WsprryPi/Wsprry_Pi_Hat_Designs/README.md

# Wsprry Pi µHAT
