WsprryPi/Wsprry_Pi_Hat_Designs/Wsprry Pi µHAT/KiCad Design/Wsprry_Pi_uHAT.kicad_pcb

## KiCad design Wsprry Pi µHAT/KiCad Design/Wsprry_Pi_uHAT.kicad_pcb (2026-02-14)

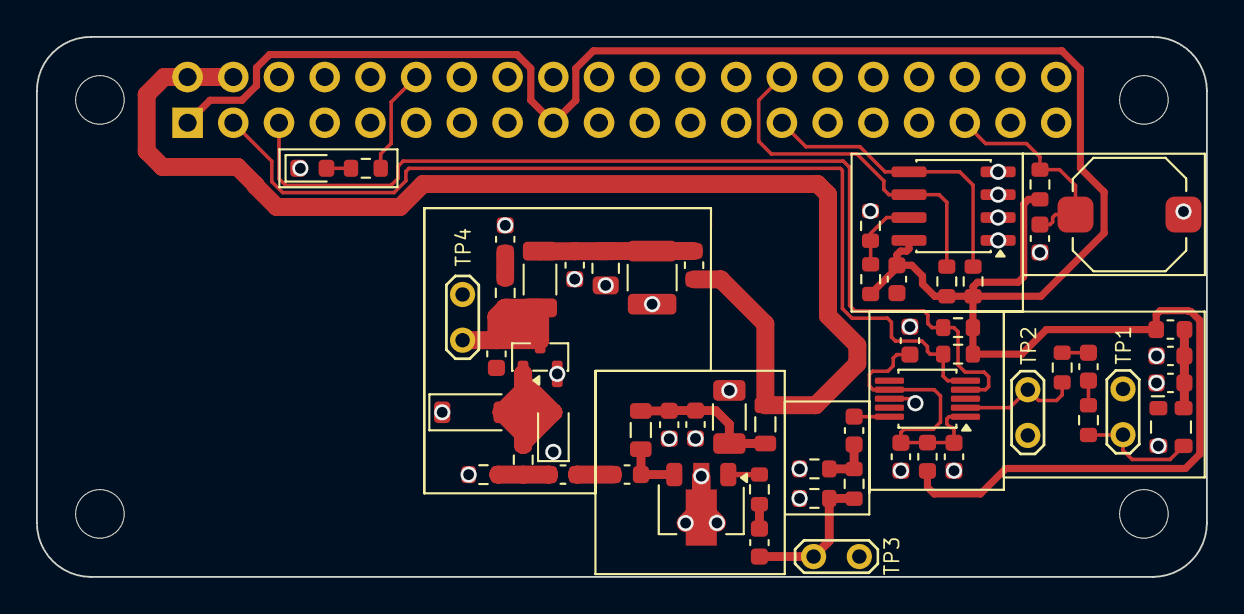
[picture p1: board Wsprry_Pi_uHAT.kicad_pcb from above]

Board: 2 copper layers, 65.0 x 30.0 mm, 61 parts (1 on the bottom side), 30 nets.

Parts:
C1, C5, C7, C10, C20: 0.1µF; C_0603_1608Metric
C2: 0.1uF; C_0603_1608Metric
C3: 1.0uF; C_0603_1608Metric
C4: 1nF; C_0603_1608Metric
C6, C9: 1.0µF; C_0603_1608Metric
C8: 1uF; C_0603_1608Metric
C11: 1µF; C_0603_1608Metric
C12: 10µF; C_1206_3216Metric
C13: 0.1F; C_0603_1608Metric
C14: 100n; C_0603_1608Metric
C15: 22nF; C_0603_1608Metric
C16: 22pF; C_0603_1608Metric
C17: 100pF; C_0603_1608Metric
C18: 10µF; C_1210_3225Metric
C19: 1.0µF; C_0805_2012Metric
D1: RED; LED_0603_1608Metric
D2: BAT54J; D_SOD-323F
D3: 5.1V; D_SOD-123
FB1, FB2: 600Ω@100MHz; L_0603_1608Metric
FB3: 600Ω100MHz; L_0805_2012Metric
FB4: 600Ω@100MHZ; L_0603_1608Metric
J1: Raspberry Pi Header; PinSocket_2x20_P2.54mm_Vertical
L1: 2.2µH; L_0805_2012Metric
L2: 2.2µH; L_1206_3216Metric
MH1, MH2, MH3, MH4: MountingHole_2.7mm_M2.5
Q1: AO3400A; SOT-23
R1: 270Ω; R_0603_1608Metric
R2: 10kΩ; R_0603_1608Metric
R3: 33Ω; R_0603_1608Metric
R4, R7, R13: 0Ω; R_0603_1608Metric
R5, R6: 2K2; R_0603_1608Metric
R8, R10: 292Ω; R_0603_1608Metric
R9: 17.6Ω; R_0603_1608Metric
R11: 47kΩ; R_0603_1608Metric
R12, R14: 3.9K; R_0603_1608Metric
R15: 49.9Ω; R_0603_1608Metric
R16: 10Ω; R_0603_1608Metric
R17: 100Ω; R_0603_1608Metric
SW1: SW_Push; SW_Push_1TS009xxxx-xxxx-xxxx_6x6x5mm
TP1: TP_XRAW; TestPoint_2Pads_Pitch2.54mm_Drill0.8mm
TP2: TP_XREF; TestPoint_2Pads_Pitch2.54mm_Drill0.8mm
TP3: TP_PAD_OUT; TestPoint_2Pads_Pitch2.54mm_Drill0.8mm
TP4: TP_PAOUT; TestPoint_2Pads_Pitch2.54mm_Drill0.8mm
U1: GVA-84; SOT-89-3
U2: 24LC128; SOIC-8_3.9x4.9mm_P1.27mm
Y1: ATX-11-F-27.000MHZ-F05-T; Oscillator_SMD_SeikoEpson_TG2520SMN-xxx-xxxxxx-4Pin_2.5x2.0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
Y2: Si5351A-B-GT; MSOP-10_3x3mm_P0.5mm

Connections:
3V3: C14.2, FB1.2, FB2.1, J1.1 (3V3), J1.17 (3V3), R2.1, R5.2, R6.2, R12.1, R13.2, R14.1, U2.8 (VCC)
5V: FB3.2, FB4.1, J1.2 (5V), J1.4 (5V)
/HAT+ EEPROM/ID_SCL: J1.28 (ID_SCL), R14.2, U2.6 (SCL)
/HAT+ EEPROM/ID_SDA: J1.27 (ID_SDA), R12.2, U2.5 (SDA)
/Raspberry Pi Header/PI_SCL: J1.5 (I2C1_SCL), R5.1, Y2.4 (SCL)
/Raspberry Pi Header/PI_SDA: J1.3 (I2C1_SDA), R6.1, Y2.5 (SDA)
/Raspberry Pi Header/PI_SHUTDOWN: C1.1, J1.35 (GPIO19), R2.2, SW1.1
/Raspberry Pi Header/PI_TXLED: J1.12 (GPIO18), R1.2
/Si5153 Chain/3dB Pi Pad/3DB_PAD_OUT: C8.1, R9.2, R10.1, TP3.1
/Si5153 Chain/3dB Pi Pad/CLOCK_IN: C13.1, Y2.10 (CLK0)
/Si5153 Chain/Clock/XTAL_IN: R4.2, TP2.1, Y2.2 (XA)
/Si5153 Chain/Final PA/MMIC_IN: C11.1, C15.1
/Si5153 Chain/Final PA/PA_OUT: C16.2, L2.2, Q1.3 (D), R17.1, TP4.1
GND: C1.2, C2.1, C3.1, C5.2, C6.2, C7.2, C9.2, C10.2, C12.2, C14.1, C16.1, C17.2, C18.2, C19.2, C20.2, D1.1 (K), D2.1 (K), D3.1 (K), J1.9 (GND), J1.25 (GND), J1.39 (GND), Q1.2 (S), R8.2, R10.2, R11.2, R15.2, SW1.2, TP1.2, TP2.2, TP3.2, TP4.2, U1.2 (GND), U2.1 (A0), U2.2 (A1), U2.3 (A2), U2.4 (GND), Y1.2 (GND), Y2.8 (GND)
unnamed: C4.1, R3.2
unnamed: C4.2, R4.1
unnamed: C8.2, R7.1
unnamed: C9.1, C10.1, C12.1, FB3.1, L1.1
unnamed: C11.2, L1.2, U1.3
unnamed: C13.2, R8.1, R9.1
unnamed: C15.2, R15.1, R16.1
unnamed: C17.1, R17.2
unnamed: C18.1, C19.1, C20.1, FB4.2, L2.1
unnamed: D1.2 (A), R1.1
unnamed: D2.2 (A), D3.2 (A), Q1.1 (G), R16.2
unnamed: R7.2, U1.1
unnamed: R11.1, R13.1, U2.7 (WP)
unnamed: R3.1, TP1.1, Y1.3 (OUT)
unnamed: C2.2, C3.2, FB1.1, Y1.4 (Vcc)
unnamed: C5.1, C6.1, C7.1, FB2.2, Y2.1 (VDD), Y2.7 (VDDO)
