WsprryPi/Wsprry_Pi_Hat_Designs/Raspberry Pi HAT EEPROM/KiCad Design/Raspberry Pi HAT EEPROM.kicad_sch

## KiCad design Raspberry Pi HAT EEPROM/KiCad Design/Raspberry Pi HAT EEPROM.kicad_sch (2026-02-14)

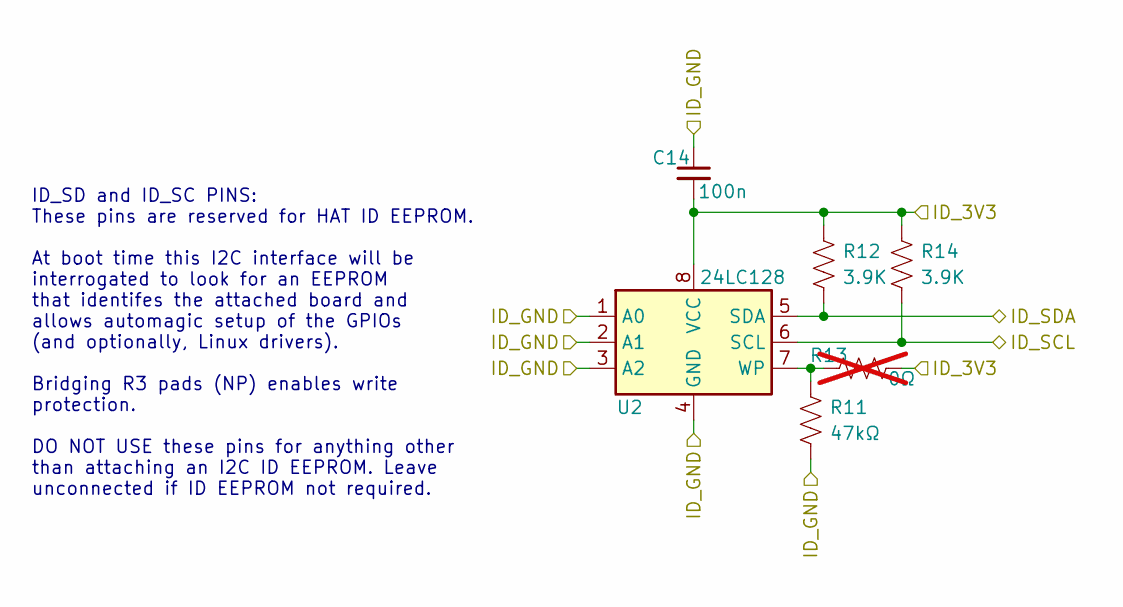
[picture p2: schematic Raspberry Pi HAT EEPROM.kicad_sch]

Parts:
C14: 100n; C_0603_1608Metric
R11: 47kΩ; R_0603_1608Metric
R12, R14: 3.9K; R_0603_1608Metric
R13: 0Ω; R_0603_1608Metric; not fitted
U2: 24LC128; SOIC-8_3.9x4.9mm_P1.27mm

Connections:
ID_3V3: C14.2, R12.1, R13.2, R14.1, U2.8 (VCC)
ID_GND: C14.1, R11.2, U2.1 (A0), U2.2 (A1), U2.3 (A2), U2.4 (GND)
ID_SCL: R14.2, U2.6 (SCL)
ID_SDA: R12.2, U2.5 (SDA)
unnamed: R11.1, R13.1, U2.7 (WP)

Notes on the sheet:
ID_SD and ID_SC PINS: These pins are reserved for HAT ID EEPROM. At boot time this I2C interface will be interrogated to look for an EEPROM that identifes the attached board and allows automagic setup of the GPIOs (and optionally, Linux drivers). Bridging R3 pads (NP) enables write protection. DO N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
