WsprryPi/Wsprry_Pi_Hat_Designs/Wsprry Pi Controls/KiCad Design/Wsprry Pi Controls.kicad_sch

## KiCad design Wsprry Pi Controls/KiCad Design/Wsprry Pi Controls.kicad_sch (2026-02-14)

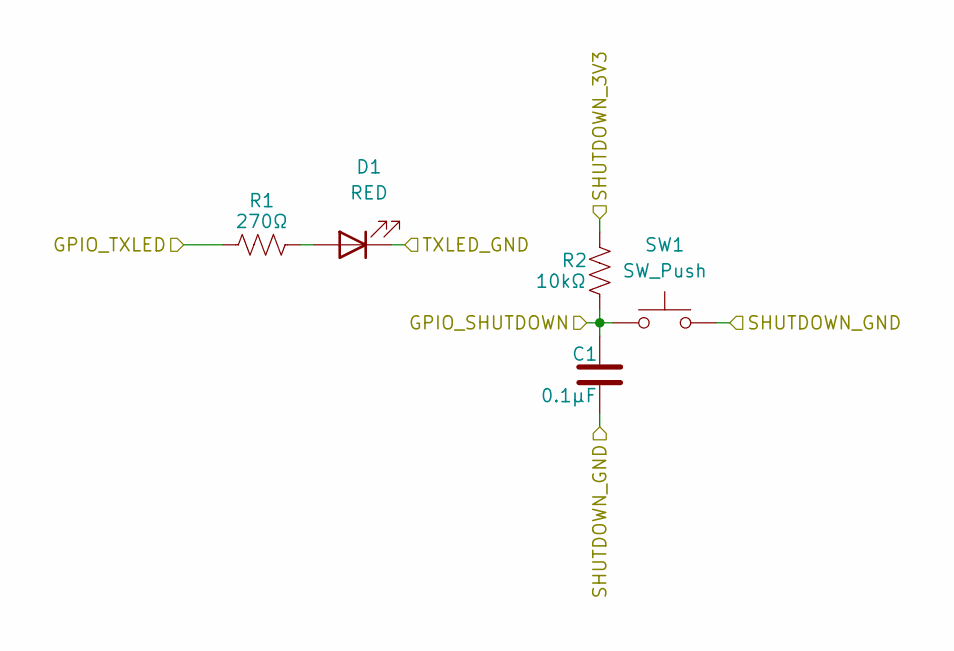
[picture p3: schematic Wsprry Pi Controls.kicad_sch]

Parts:
C1: 0.1µF; C_0603_1608Metric
D1: RED; LED_0603_1608Metric
R1: 270Ω; R_0603_1608Metric
R2: 10kΩ; R_0603_1608Metric
SW1: SW_Push; SW_Push_1TS009xxxx-xxxx-xxxx_6x6x5mm

Connections:
GPIO_SHUTDOWN: C1.1, R2.2, SW1.1
GPIO_TXLED: R1.2
unnamed: D1.2 (A), R1.1
SHUTDOWN_3V3: R2.1
SHUTDOWN_GND: C1.2, SW1.2
TXLED_GND: D1.1 (K)
