WsprryPi/Wsprry_Pi_Hat_Designs/WSPR Si5153 RF Chain/Components/3dB Pi Pad/KiCad Design/3dB Pad.kicad_sch

## KiCad design WSPR Si5153 RF Chain/Components/3dB Pi Pad/KiCad Design/3dB Pad.kicad_sch (2026-02-14)

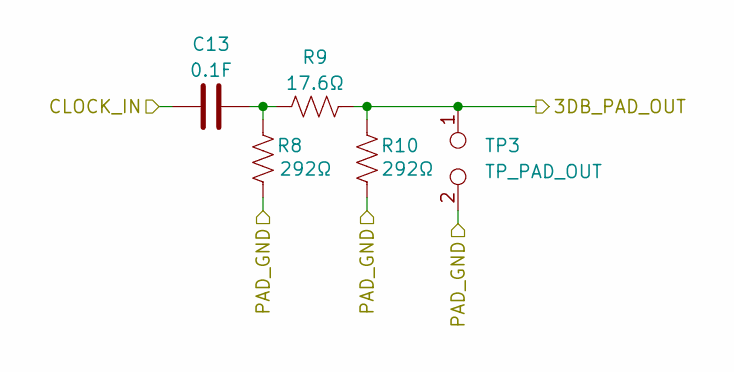
[picture p4: schematic 3dB Pad.kicad_sch]

Parts:
C13: 0.1F; C_0603_1608Metric
R8, R10: 292Ω; R_0603_1608Metric
R9: 17.6Ω; R_0603_1608Metric
TP3: TP_PAD_OUT; TestPoint_2Pads_Pitch2.54mm_Drill0.8mm

Connections:
3DB_PAD_OUT: R9.2, R10.1, TP3.1
CLOCK_IN: C13.1
unnamed: C13.2, R8.1, R9.1
PAD_GND: R8.2, R10.2, TP3.2
