WsprryPi/Wsprry_Pi_Hat_Designs/WSPR Si5153 RF Chain/Components/6dB Pi Pad/KiCad Design/6dB Pad.kicad_sch

## KiCad design WSPR Si5153 RF Chain/Components/6dB Pi Pad/KiCad Design/6dB Pad.kicad_sch (2026-02-09)

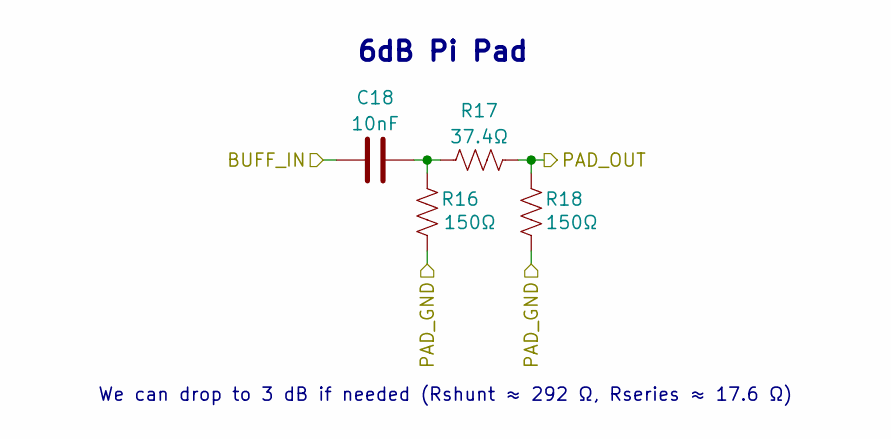
[picture p5: schematic 6dB Pad.kicad_sch]

Parts:
C18: 10nF; C_0805_2012Metric
R16, R18: 150Ω; R_0603_1608Metric
R17: 37.4Ω; R_0603_1608Metric

Connections:
BUFF_IN: C18.1
unnamed: C18.2, R16.1, R17.1
PAD_GND: R16.2, R18.2
PAD_OUT: R17.2, R18.1

Notes on the sheet:
6dB Pi Pad
We can drop to 3 dB if needed (Rshunt ≈ 292 Ω, Rseries ≈ 17.6 Ω)
