WsprryPi/Wsprry_Pi_Hat_Designs/WSPR Si5153 RF Chain/Components/27 MHz TCXO Block/KiCad Design/27 MHz TCXO Block.kicad_sch

## KiCad design WSPR Si5153 RF Chain/Components/27 MHz TCXO Block/KiCad Design/27 MHz TCXO Block.kicad_sch (2026-02-14)

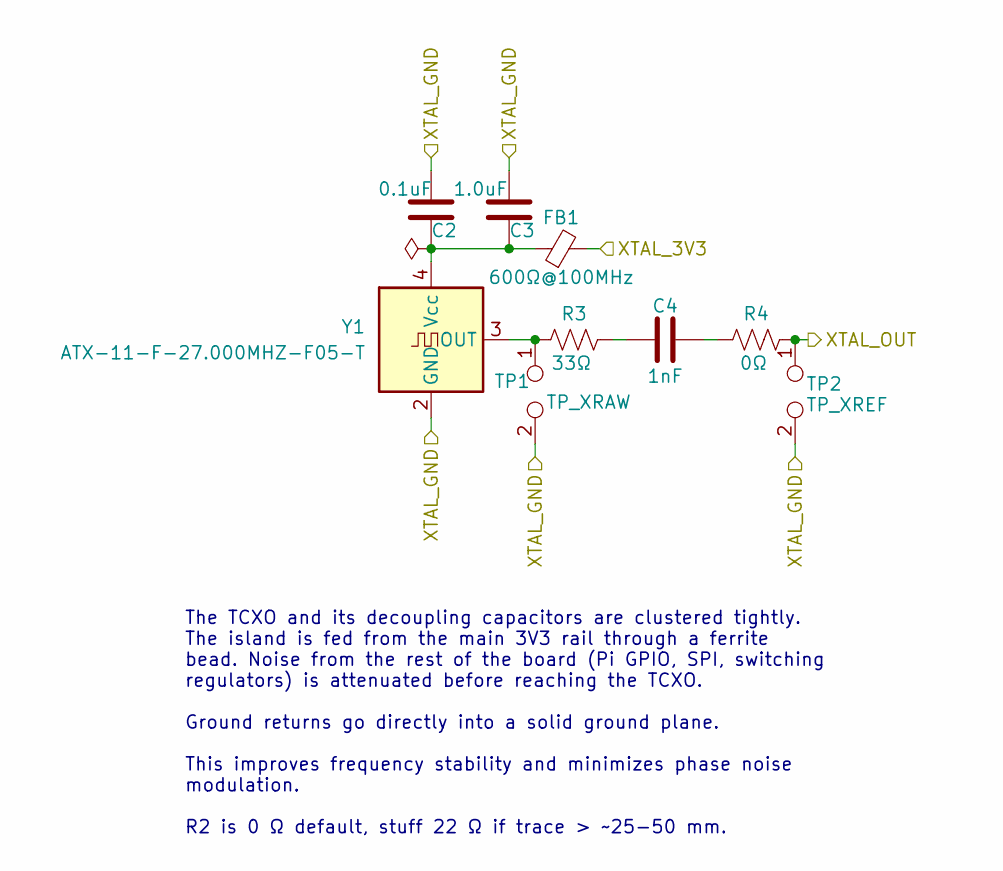
[picture p6: schematic 27 MHz TCXO Block.kicad_sch]

Parts:
C2: 0.1uF; C_0603_1608Metric
C3: 1.0uF; C_0603_1608Metric
C4: 1nF; C_0603_1608Metric
FB1: 600Ω@100MHz; L_0603_1608Metric
R3: 33Ω; R_0603_1608Metric
R4: 0Ω; R_0603_1608Metric
TP1: TP_XRAW; TestPoint_2Pads_Pitch2.54mm_Drill0.8mm
TP2: TP_XREF; TestPoint_2Pads_Pitch2.54mm_Drill0.8mm
Y1: ATX-11-F-27.000MHZ-F05-T; Oscillator_SMD_SeikoEpson_TG2520SMN-xxx-xxxxxx-4Pin_2.5x2.0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

Connections:
unnamed: C2.2, C3.2, FB1.1, Y1.4 (Vcc)
unnamed: C4.1, R3.2
unnamed: C4.2, R4.1
unnamed: R3.1, TP1.1, Y1.3 (OUT)
XTAL_3V3: FB1.2
XTAL_GND: C2.1, C3.1, TP1.2, TP2.2, Y1.2 (GND)
XTAL_OUT: R4.2, TP2.1

Notes on the sheet:
The TCXO and its decoupling capacitors are clustered tightly. The island is fed from the main 3V3 rail through a ferrite bead. Noise from the rest of the board (Pi GPIO, SPI, switching regulators) is attenuated before reaching the TCXO. Ground returns go directly into a solid ground plane. This imp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
