WsprryPi/Wsprry_Pi_Hat_Designs/WSPR Si5153 RF Chain/Components/Broadband MMIC Gain Block/KiCad Design/Broadband_MMIC_Gain_Block.kicad_sch

## KiCad design WSPR Si5153 RF Chain/Components/Broadband MMIC Gain Block/KiCad Design/Broadband_MMIC_Gain_Block.kicad_sch (2026-02-14)

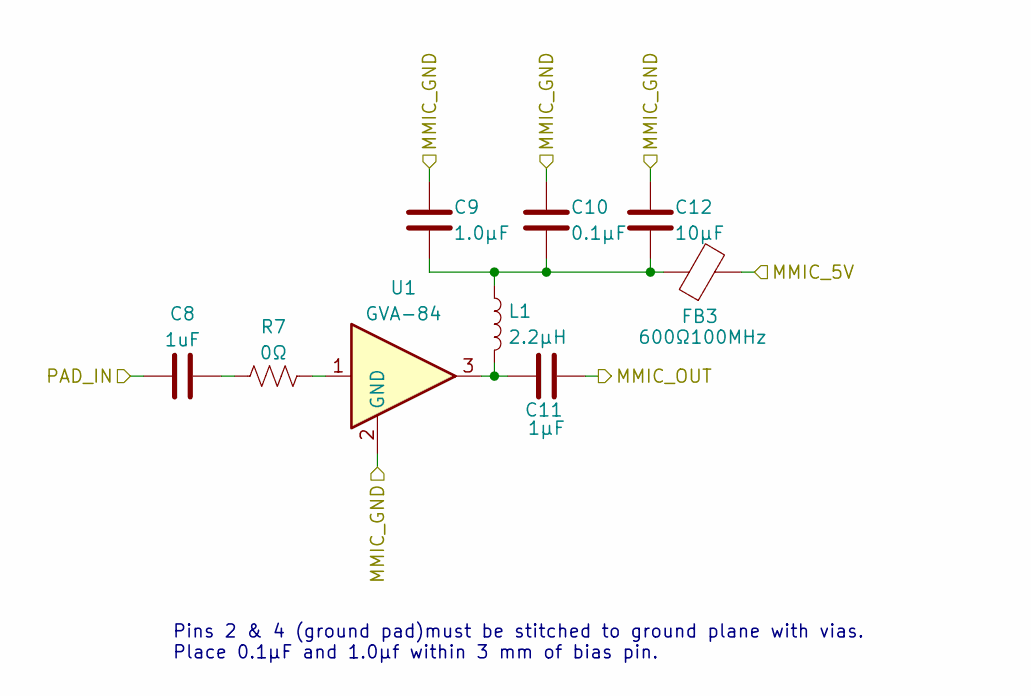
[picture p7: schematic Broadband_MMIC_Gain_Block.kicad_sch]

Parts:
C8: 1uF; C_0603_1608Metric
C9: 1.0µF; C_0603_1608Metric
C10: 0.1µF; C_0603_1608Metric
C11: 1µF; C_0603_1608Metric
C12: 10µF; C_1206_3216Metric
FB3: 600Ω100MHz; L_0805_2012Metric
L1: 2.2µH; L_0805_2012Metric
R7: 0Ω; R_0603_1608Metric
U1: GVA-84; SOT-89-3

Connections:
MMIC_5V: FB3.2
MMIC_GND: C9.2, C10.2, C12.2, U1.2 (GND)
MMIC_OUT: C11.1
unnamed: C8.2, R7.1
unnamed: C9.1, C10.1, C12.1, FB3.1, L1.1
unnamed: C11.2, L1.2, U1.3
unnamed: R7.2, U1.1
PAD_IN: C8.1

Notes on the sheet:
Pins 2 & 4 (ground pad)must be stitched to ground plane with vias. Place 0.1µF and 1.0µf within 3 mm of bias pin.
