WsprryPi/Wsprry_Pi_Hat_Designs/WSPR Si5153 RF Chain/Components/PA/KiCad Design/PA.kicad_sch

## KiCad design WSPR Si5153 RF Chain/Components/PA/KiCad Design/PA.kicad_sch (2026-02-14)

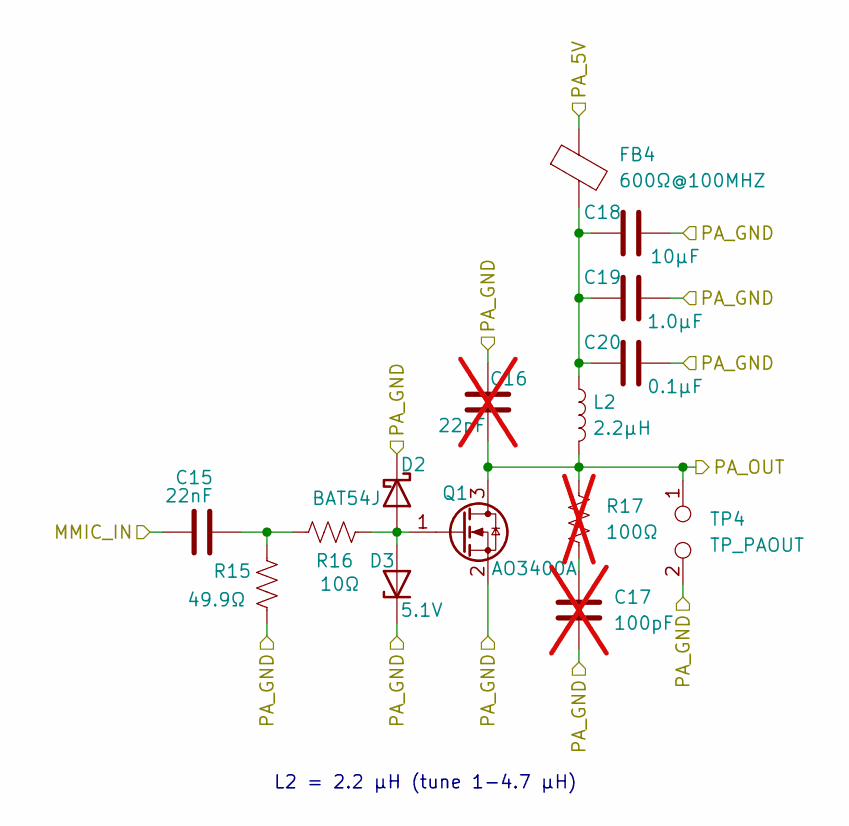
[picture p8: schematic PA.kicad_sch]

Parts:
C15: 22nF; C_0603_1608Metric
C16: 22pF; C_0603_1608Metric; not fitted
C17: 100pF; C_0603_1608Metric; not fitted
C18: 10µF; C_1210_3225Metric
C19: 1.0µF; C_0805_2012Metric
C20: 0.1µF; C_0603_1608Metric
D2: BAT54J; D_SOD-323F
D3: 5.1V; D_SOD-123
FB4: 600Ω@100MHZ; L_0603_1608Metric
L2: 2.2µH; L_1206_3216Metric
Q1: AO3400A; SOT-23
R15: 49.9Ω; R_0603_1608Metric
R16: 10Ω; R_0603_1608Metric
R17: 100Ω; R_0603_1608Metric; not fitted
TP4: TP_PAOUT; TestPoint_2Pads_Pitch2.54mm_Drill0.8mm

Connections:
MMIC_IN: C15.1
unnamed: C15.2, R15.1, R16.1
unnamed: C17.1, R17.2
unnamed: C18.1, C19.1, C20.1, FB4.2, L2.1
unnamed: D2.2 (A), D3.2 (A), Q1.1 (G), R16.2
PA_5V: FB4.1
PA_GND: C16.1, C17.2, C18.2, C19.2, C20.2, D2.1 (K), D3.1 (K), Q1.2 (S), R15.2, TP4.2
PA_OUT: C16.2, L2.2, Q1.3 (D), R17.1, TP4.1

Notes on the sheet:
L2 = 2.2 µH (tune 1-4.7 µH)
