WsprryPi/Wsprry_Pi_Hat_Designs/WSPR Si5153 RF Chain/Components/Si5351 Clock Generator Circuit/KiCad Design/Si5351 Clock Generator Circuit.kicad_sch

## KiCad design WSPR Si5153 RF Chain/Components/Si5351 Clock Generator Circuit/KiCad Design/Si5351 Clock Generator Circuit.kicad_sch (2026-02-14)

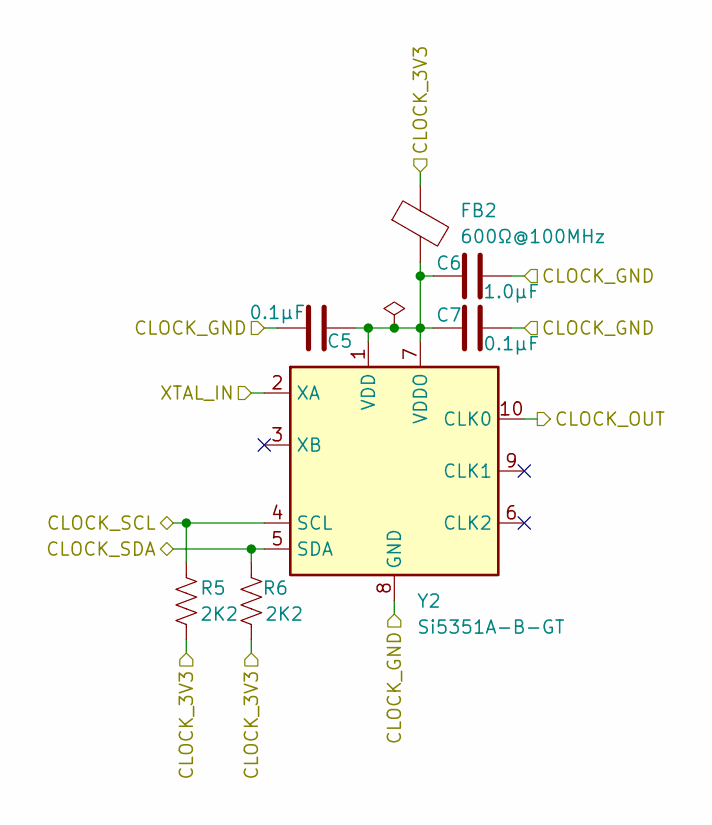
[picture p9: schematic Si5351 Clock Generator Circuit.kicad_sch]

Parts:
C5, C7: 0.1µF; C_0603_1608Metric
C6: 1.0µF; C_0603_1608Metric
FB2: 600Ω@100MHz; L_0603_1608Metric
R5, R6: 2K2; R_0603_1608Metric
Y2: Si5351A-B-GT; MSOP-10_3x3mm_P0.5mm

Connections:
CLOCK_3V3: FB2.1, R5.2, R6.2
CLOCK_GND: C5.2, C6.2, C7.2, Y2.8 (GND)
CLOCK_OUT: Y2.10 (CLK0)
CLOCK_SCL: R5.1, Y2.4 (SCL)
CLOCK_SDA: R6.1, Y2.5 (SDA)
unnamed: C5.1, C6.1, C7.1, FB2.2, Y2.1 (VDD), Y2.7 (VDDO)
XTAL_IN: Y2.2 (XA)
