WsprryPi/Wsprry_Pi_Hat_Designs/(commit log)

2026-02-09 Set up hierarchical sheets
    [27 MHz TCXO Block.kicad_pcb, 27 MHz TCXO Block.kicad_sch, 6dB Pad.kicad_pcb, 6dB Pad.kicad_sch, Broadband_MMIC_Gain_Block.kicad_sch, Primary_LPF.kicad_sch, RF Conditioning Buffer.kicad_pcb, RF Conditioning Buffer.kicad_sch]
2026-02-14 Notionally complete through PA
    [27 MHz TCXO Block.kicad_pcb, 27 MHz TCXO Block.kicad_sch, 3dB Pad.kicad_sch, 6dB Pad.kicad_pcb, Broadband_MMIC_Gain_Block.kicad_sch, HF_LPF.kicad_pcb, HF_LPF.kicad_sch, PA.kicad_sch]
