WsprryPi/Wsprry_Pi_Hat_Designs/(notices)

Notices in the files:
README.md:
License: MIT
